yasushisakai/talkingdrums/modules/nRF_TD/README.md

- for the first device, change the change the SERVER_SLAVE macro to 1
