yasushisakai/talkingdrums/(threads)

Thread 15 (2017-09-21):

solenoids stuck after few hours

yasushisakai, 2017-09-21:
solenoids gets stuck every once in a while,

- discharge
  - touch
  - add flyback or cap? pull down
  - ways we can do programmatically

Closed 2018-07-29.
