yasushisakai/talkingdrums/circuits/2017-09-15_drum_circuits.brd

## EAGLE design circuits/2017-09-15_drum_circuits.brd (2018-08-05)

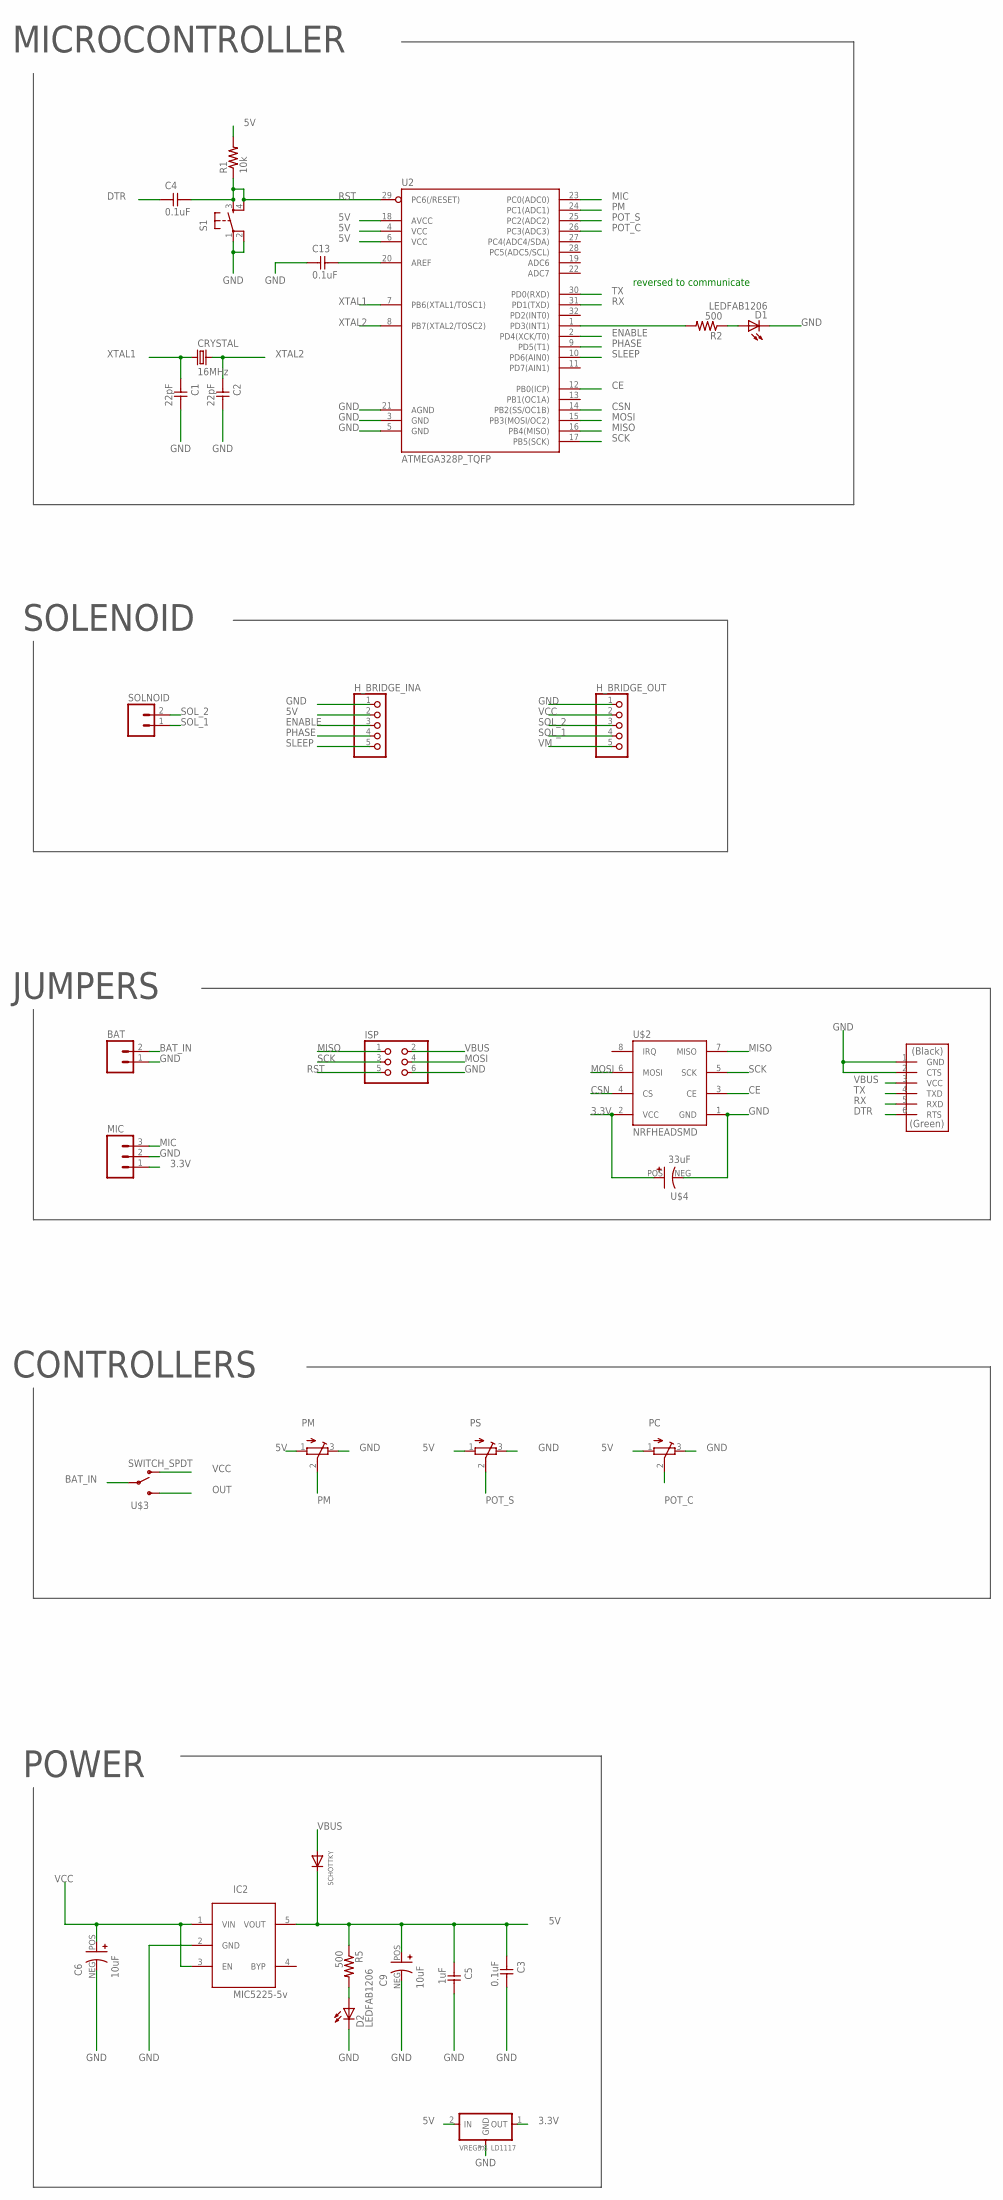
[picture p1: schematic 2017-09-15_drum_circuits.sch]

Parts:
BAT: M02PTH; 1X02
C1, C2: 22pF; C1206FAB
C3, C4, C13: 0.1uF; C1206FAB
C5: 1uF; C1206FAB
C6, C9: 10uF; PANASONIC-CAP-SMD-B
CRYSTAL: 16MHz; 2-SMD-5X3MM
D1, D2: LEDFAB1206; LED1206FAB
H_BRIDGE_INA: PINHD-1X05_2.54-SMD; 1X05SMD
H_BRIDGE_OUT: PINHD-1X05_2.54-SMD; 1X05SMD
IC2: MIC5225-5v; SOT23-5L
ISP: PINHD-2X3-SMD; 2X03SMD
MIC: M03PTH; 1X03
PC: TRIMPOTTC33X; TC33X
PM: TRIMPOTTC33X; TC33X
PS: TRIMPOTTC33X; TC33X
R1: 10k; R1206FAB
R2, R5: 500; R1206FAB
S1: 6MM_SWITCH6MM_SWITCH; 6MM_SWITCH
SCHOTTKY: DIODE_SOD-123FL; SOD-123FL
SOLNOID: M02PTH; 1X02
U2: ATMEGA328P_TQFP; TQFP32-08
U$1: FTDI-SMD-HEADER; 1X06SMD
U$2: NRFHEADSMD; 2.54MM
U$3: SWITCH_SPDT; KPS-1290
U$4: 33uF; PANASONIC-CAP-SMD-C
VREG3.3: LD1117; SOT23

Connections:
3.3V: MIC.1, U$2.2 (VCC), U$4.POS (+), VREG3.3.1 (OUT)
5V: C3.1, C5.1, C9.POS (+), H_BRIDGE_INA.2, IC2.5 (VOUT), PC.1 (A), PM.1 (A), PS.1 (A), R1.2, R5.1, SCHOTTKY.C, U2.4 (VCC), U2.6 (VCC), U2.18 (AVCC), VREG3.3.2 (IN)
BAT_IN: BAT.2, U$3.P
CE: U2.12 (PB0(ICP)), U$2.3 (CE)
CSN: U2.14 (PB2(SS/OC1B)), U$2.4 (CS)
DTR: C4.1, U$1.6 (RTS)
ENABLE: H_BRIDGE_INA.3, U2.2 (PD4(XCK/T0))
GND: BAT.1, C1.2, C2.2, C3.2, C5.2, C6.NEG (-), C9.NEG (-), C13.1, D1.2 (C), D2.2 (C), H_BRIDGE_INA.1, H_BRIDGE_OUT.1, IC2.2 (GND), ISP.6, MIC.2, PC.3 (E), PM.3 (E), PS.3 (E), S1.1, S1.2 (P1), U2.3 (GND), U2.5 (GND), U2.21 (AGND), U$1.1 (GND), U$1.2 (CTS), U$2.1 (GND), U$4.NEG (-), VREG3.3.3 (GND)
MIC: MIC.3, U2.23 (PC0(ADC0))
MISO: ISP.1, U2.16 (PB4(MISO)), U$2.7 (MISO)
MOSI: ISP.4, U2.15 (PB3(MOSI/OC2)), U$2.6 (MOSI)
unnamed: D1.1 (A), R2.1
unnamed: D2.1 (A), R5.2
unnamed: C13.2, U2.20 (AREF)
unnamed: R2.2, U2.1 (PD3(INT1))
OUT: U$3.S
PHASE: H_BRIDGE_INA.4, U2.9 (PD5(T1))
PM: PM.2 (S), U2.24 (PC1(ADC1))
POT_C: PC.2 (S), U2.26 (PC3(ADC3))
POT_S: PS.2 (S), U2.25 (PC2(ADC2))
RST: C4.2, ISP.5, R1.1, S1.3 (S), S1.4 (S1), U2.29 (PC6(/RESET))
RX: U2.31 (PD1(TXD)), U$1.5 (RXD)
SCK: ISP.3, U2.17 (PB5(SCK)), U$2.5 (SCK)
SLEEP: H_BRIDGE_INA.5, U2.10 (PD6(AIN0))
SOL_1: H_BRIDGE_OUT.4, SOLNOID.1
SOL_2: H_BRIDGE_OUT.3, SOLNOID.2
TX: U2.30 (PD0(RXD)), U$1.4 (TXD)
VBUS: ISP.2, SCHOTTKY.A, U$1.3 (VCC)
VCC: C6.POS (+), H_BRIDGE_OUT.2, IC2.1 (VIN), IC2.3 (EN), U$3.O
VM: H_BRIDGE_OUT.5
XTAL1: C1.1, CRYSTAL.P$1 (1), U2.7 (PB6(XTAL1/TOSC1))
XTAL2: C2.1, CRYSTAL.P$2 (2), U2.8 (PB7(XTAL2/TOSC2))

Notes on the sheet:
reversed to communicate
JUMPERS
MICROCONTROLLER
POWER
SOLENOID
CONTROLLERS

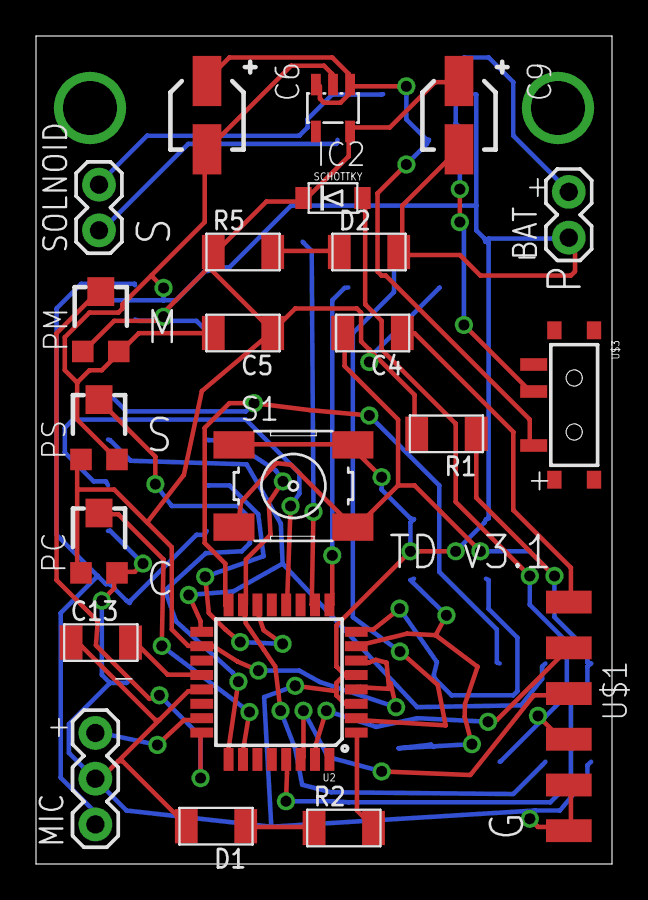
[picture p2: board 2017-09-15_drum_circuits.brd from above]

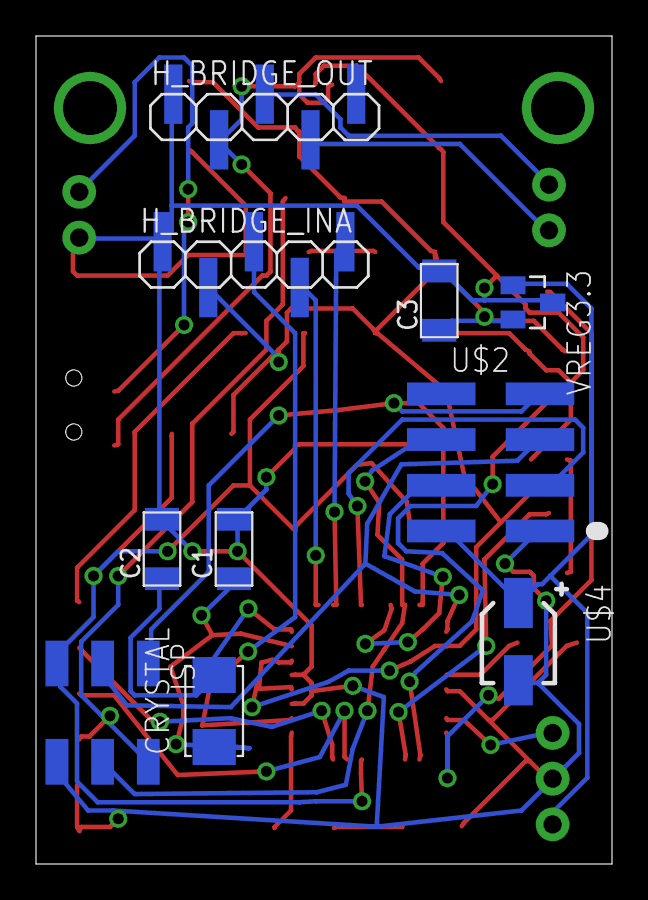
[picture p3: board 2017-09-15_drum_circuits.brd from below]

Board: 2 copper layers, 32.0 x 46.0 mm, 32 parts (10 on the bottom side), 30 nets.
