yasushisakai/talkingdrums/modules/nRF_TD/clock/defines.h

#define LED_PIN 3
#define SOLENOID_PIN 5

#define LED_PIN_00 6
#define LED_PIN_01 5
#define LED_PIN_02 6
#define LED_PIN_03 A1
#define LED_PIN_04 A2
#define LED_PIN_05 A3
#define LED_PIN_06 A4
#define LED_PIN_07 A5

// clock interval in ms
#define DURATION 250
#define COUNTER_LIMIT 3
