yasushisakai/talkingdrums/start_and_end/receiver/SerialHandler.pde

import processing.serial.*;

final byte RETURN = 0b00001010;
final byte READY = 0b00000000;
final byte SEND = 0b00000001;
final byte RECEIVE = 0b00000010;
final int BAUD = 115200;

class SerialHandler{

  public Serial port;

  SerialHandler(PApplet p) throws Exception {
    this.connect(p);
  }

  public void connect(PApplet p) throws Exception{
    String[] portList = Serial.list();
    String portName = portList[portList.length - 1];
      try{ 
        this.port = new Serial(p, portName, BAUD);
      } catch (Exception e) {
        println("Error connecting to Serial :" + e);
        throw e;
      }

    println("connected to: " + portName);
  }

  public boolean checkReady() {
    while(this.port.available() > 0){
      byte[] incomming = new byte[]{0, 0, 0}; 
      incomming = this.port.readBytes(3);
      printArray(incomming);
      return incomming[0] == READY && incomming[2] == RETURN;
    }
    return false;
  }
  
  public byte getByte() throws Exception{
    while(this.port.available() > 0){
      byte[] incomming = new byte[]{0,0,0};
      incomming = this.port.readBytes(3);
      if(incomming[0] == RECEIVE && incomming[2] ==RETURN){
        // printArray(incomming);
        byte d = (byte) incomming[1];
        println("got message: "+ formatByte(d));
        return d;
      } else{
        throw new Exception("message wrong protocol");
      }
    }
    throw new Exception("invalid message");
  }

  public void sendByte(byte data){
    // compose message 
    byte[] m = new byte[3];
    m[0] = SEND;
    m[1] = data;
    m[2] = RETURN; 

    this.port.write(m);
    this.port.clear();
  }
}
