yasushisakai/talkingdrums/modules/nRF_TD/slave_interupt/Notes.ino

/*
 * 
 * Module 1 - >
 *
const int THRESHOLD_PEAK = 90;//68; //38

const float f_s   = 0.012; //0.023
const float bw_s  = 0.012; //0.25
const float EMA_a_low_s   = 0.12;  //0.18    //initialization of EMA alpha (cutoff-frequency)
const float EMA_a_high_s  = 0.47;  //0.87


 * Module 2 - >
 * 
 * 
 * Module 3 - >
 * 
 * 
 * Module 4 - >
 *  
 * 
 * Module 5 - >
 * 
 * const int THRESHOLD_PEAK = 90;//68; //38

const float f_s   = 0.012; //0.023
const float bw_s  = 0.012; //0.25
const float EMA_a_low_s   = 0.12;  //0.18    //initialization of EMA alpha (cutoff-frequency)
const float EMA_a_high_s  = 0.57;  //0.87

 *  
 * Module 6 - >
 * 
 * 
 * Module 7 - >
 *   
 *  
 * Module 8 - >
 *    
 *   
 * Module 9 - >
 *     
 *    
 * Module 10 - >
 * 
 * 
 */
