yasushisakai/talkingdrums/modules/Tests/nrf24_client_Solenoid/nrf24_client_Solenoid.ino

// nrf24_client.pde
// -*- mode: C++ -*-
// Example sketch showing how to create a simple messageing client
// with the RH_NRF24 class. RH_NRF24 class does not provide for addressing or
// reliability, so you should only use RH_NRF24 if you do not need the higher
// level messaging abilities.
// It is designed to work with the other example nrf24_server.
// Tested on Uno with Sparkfun NRF25L01 module
// Tested on Anarduino Mini (http://www.anarduino.com/mini/) with RFM73 module
// Tested on Arduino Mega with Sparkfun WRL-00691 NRF25L01 module

#include <SPI.h>
#include <RH_NRF24.h>

// Singleton instance of the radio driver
RH_NRF24 nrf24;
// RH_NRF24 nrf24(8, 7); // use this to be electrically compatible with Mirf
// RH_NRF24 nrf24(8, 10);// For Leonardo, need explicit SS pin
// RH_NRF24 nrf24(8, 7); // For RFM73 on Anarduino Mini

int STATE = LOW;

void setup()
{

  pinMode(3, OUTPUT);
  pinMode(4, OUTPUT);

  digitalWrite(3, HIGH);
  digitalWrite(4, HIGH);
  delay(200);


  digitalWrite(3, LOW);
  digitalWrite(4, LOW);

  int failed = 0;


  if (!nrf24.init()) {
    failed = 1;
  }

  if (!nrf24.setChannel(1)) {
    failed = 1;
  }

  if (!nrf24.setRF(RH_NRF24::DataRate2Mbps, RH_NRF24::TransmitPower0dBm)) {
    failed = 1;
  }

  if (failed == 1) {
    digitalWrite(3, HIGH);
    digitalWrite(4, HIGH);
    delay(500);

    digitalWrite(3, LOW);
    digitalWrite(4, LOW);
    delay(200);

    digitalWrite(3, HIGH);
    digitalWrite(4, HIGH);
    delay(500);

    digitalWrite(3, LOW);
    digitalWrite(4, LOW);
    delay(200);

  }

  digitalWrite(3, LOW);
  digitalWrite(4, LOW);

}


void loop()
{

  uint8_t buf[RH_NRF24_MAX_MESSAGE_LEN];
  uint8_t len = sizeof(buf);

  //if (nrf24.waitAvailableTimeout(50))
 // {
    // Should be a reply message for us now
    if (nrf24.recv(buf, &len))
    {
      int value = buf[0] - 48;

      if (value == 0) {
        STATE = LOW;
      } else {
        STATE = HIGH;

      }

    }
 // }

  digitalWrite(3, STATE);
  digitalWrite(4, STATE);

}
