yasushisakai/talkingdrums/modules/Tests/bare_test/define.h

#ifndef Define_h
#define Define_h

// pins
#define LED_PIN 3
#define SOL_PIN 4
#define MIC_PIN A0

// server values
#define TICK 49
#define TOCK 48

//sequences
#define SEQITER 3
#define SEQBITS 8
#define INTERVAL 50

// modes
#define WAIT 0
#define LISTEN 1
#define ANALYZE 2
#define PLAYPULSE 3
#define REPLAY 4

#endif
