yasushisakai/talkingdrums/(commit log)

2016-06-28 arduino microphone
2016-06-28 added sparkfun arduino reference board
    [Arduino-Pro-Mini.brd, Arduino-Pro-Mini.sch]
2016-06-29 hit solenoid
    [Arduino-Pro-Mini.brd, Arduino-Pro-Mini.sch, Electret_Microphone_Breakout.brd, Electret_Microphone_Breakout.sch, drum_circuits.brd, drum_circuits.sch]
2016-06-30 fix bugs with timer
    [sendTestSequnece.ino]
2016-07-08 master slave arduino projects
2016-07-26 finally started the schematic
    [drum_circuits.sch]
2016-08-17 fix timing in server/clients
    [TimeKeeper.cpp, TimeKeeper.h, clock.ino, define.h, helpers.cpp, helpers.h]
2016-08-24 fixed byte error in format
    [clock.ino, helpers.cpp]
2016-08-31 got rid of ‘0’ before B
2018-07-31 arduino test serial_write modified to test sending bytes, not the protocol
2018-08-01 arduino test write, sending three values
2018-08-03 ftdi cable script
2018-08-05 clean circuits and modules
    [2017-09-15_drum_circuits.brd, 2017-09-15_drum_circuits.sch, digikey_all.xlsx, digikey_mic_only.csv, digikey_parts.csv, digikey_without_mic.csv]
2018-08-07 exceptions on invalid short messages
    [SerialHandler.pde, sender.pde]
2018-08-12 receiver error img check
    [DisplayImg.pde]
